samrpat/light-alarm-clock/README.md

# light-alarm-clock
A custom alarm clock to replace current one and add more features.

Sunrise light, sleep sounds and a gesture-driven round touchscreen, built on an ESP32-S3.
Start with [docs/README.md](docs/README.md).
