samrpat/light-alarm-clock/docs/POWER.md

# Power design

Phase 1 · 2026-11-12 · Decisions: [D-012](DECISIONS.md), [D-013](DECISIONS.md), [D-014](DECISIONS.md)

**All currents below are estimates from datasheet-typical figures. None has been measured yet.**
Section 9 lists the bench measurements that replace them.

## 1. Architecture in one picture

```mermaid
flowchart LR
  PSU[USB-C adapter<br/>5 V, 3 A] --> USBC[Board USB-C]
  USBC --> VBUS((VBUS))
  VBUS --> AXP[AXP2101<br/>input limit 1.0 A]
  AXP --> R33[3.3 V rails:<br/>ESP32, display, codec]
  AXP <--> BAT[Li-ion 2000 mAh<br/>backup, MX1.25]
  AXP --> RTC[PCF85063 RTC]
  VBUS -- header pin 1 --> PTC[PTC fuse 1.1 A] --> CAP[1000 µF] --> RING[RGBW ring<br/>firmware cap 0.9 A]
  VBUS --> LS[74AHCT125]
  GPIO17 --> LS -- 470 Ω --> RING
```

- **USB-C is the main supply.** The ring takes 5 V directly from the header's VBUS pin.
- **The battery is a backup.** It carries the clock, the RTC and the alarm sound through an unplug or a power cut. The ring is off on battery.
- **No boost converter** in the baseline. Section 8 describes it as an optional upgrade.

## 2. LED ring load (24 × RGBW)

| Case | Channels on | Ring current at 5 V |
|---|---|---|
| Powered but dark (driver quiescent, ~1 mA each) | none | ~25 mA |
| Night light, red at 3 % | R | ~40 mA |
| Reading light, white at 60 % | W | ~285 mA |
| White LED at 100 % | W | ~455 mA |
| Sunrise peak (white 100 % + warm tint) | W + R + part G | ~0.85 A |
| Everything at 100 % (never allowed) | R+G+B+W | ~1.75 A |

Per-channel figure used: 18 mA (Adafruit's stated constant current).

**Firmware current cap (R14):** before every frame, `light_fx` adds up
`I = 25 mA + Σ(r+g+b+w) × 18 mA / 255` over all 24 pixels.
If `I > 900 mA`, every channel is scaled down by `900 / I`. No mode can bypass this.

**Hardware backstop:** a 1.1 A-hold resettable fuse (Bourns MF-R110) in the ring's 5 V line. If firmware ever fails with all channels on, the fuse trips instead of the adapter or the board trace.

**Weak-charger guard:** `power_mon` reads VBUS voltage from the AXP2101 once a second while the ring is lit. Below 4.6 V the cap drops in 20 % steps until VBUS recovers.

**The dawn (LIGHT.md §3) peaks at about 0.6 A:** 24 LEDs with white at full and a little red, green and blue, about 25 mA of idle current, well under the 0.9 A cap. The night face and the ring-off rule mean the ring draws almost nothing overnight.

## 3. Level shifting and protection parts

| Part | Value | Why |
|---|---|-----|
| 74AHCT125 (one gate, VCC = VBUS) | — | The ring needs a data high of at least 0.7 × 5 V = 3.5 V. The ESP32 gives 3.3 V. AHCT reads 3.3 V as high and outputs 5 V. |
| Series resistor at ring DIN | 470 Ω | Damps ringing on the data wire and limits current into the first pixel. |
| Pull-down on gate input (GPIO17) | 10 kΩ | Holds data low while the ESP32 boots, so the ring doesn't flash random colours. |
| Bulk capacitor across ring 5 V/GND | 1000 µF, 10 V | Absorbs the current step when the ring changes brightness. If an adapter hiccups at plug-in from the inrush, drop to 470 µF. |
| Decoupling at the 74AHCT125 | 100 nF | Standard. |
| Unused gates (3) | inputs to GND, /OE to VCC | Stops them floating. |

AHCT inputs accept a signal while their own supply is off, so GPIO17 cannot back-feed VBUS when USB is unplugged. Firmware also parks GPIO17 low when VBUS is absent.

## 4. Power budget

Converted to current at the 5 V USB input (3.3 V loads ÷ 0.88 regulator efficiency).

| State | Board | Ring | Total at 5 V |
|---|---|---|---|
| A. Night clock, dim | 45 mA | 25 mA | **~70 mA** |
| B. White noise playing | 75 mA | 25 mA | **~100 mA** |
| C. Night light | 45 mA | 40 mA | **~85 mA** |
| D. Reading light 60 % | 50 mA | 285 mA | **~335 mA** |
| E. Sunrise at peak | 75 mA | 900 mA (cap) | **~1.0 A** |
| F. Alarm, full volume, sunrise full | 410 mA | 900 mA | **~1.3 A** |
| G. F + battery charging | 1000 mA (PMIC limit) | 900 mA | **1.9 A max** |

Board-side detail used above (at 3.3 V): ESP32-S3 ~40 mA average with radios idle, up to 340 mA in Wi-Fi bursts · AMOLED ~10 mA dim, ~100 mA full white · codec ~15 mA · sensors and PMIC ~5 mA · amplifier ~25 mA for white noise, ~1.2 W at full alarm volume.

**Adapter:** 5 V, **3 A**, USB-C (for example the Raspberry Pi 15 W supply, 5.1 V / 3 A). A phone charger of 2 A or more works; the weak-charger guard dims the ring if it sags. A laptop port (0.5–0.9 A) will run the clock but not the full sunrise.

## 5. PMIC (AXP2101) settings, applied at every boot

| Setting | Value | Reason |
|---|---|---|
| VBUS input current limit | 1000 mA | Leaves the rest of the adapter for the ring. |
| Battery charge current | 400 mA (0.2 C for 2000 mAh) | Gentle on the cell, low heat in a closed case. |
| Charge target voltage | **4.1 V** (owner choice) | The clock lives on USB, and 4.1 V gives much longer cell life. Costs about 10 % of capacity; the runtime table below already has that margin. |
| PWR-key long-press power-off | Disabled (or 10 s if it can't be disabled) | R27: no accidental power-off. |
| IRQs enabled | VBUS insert/remove, battery low, charge done, PWR key | Read through TCA9554 P5; also polled every 1 s. |
| Fuel gauge | Enabled | Battery % for R24/R25. |

Register names and library calls are confirmed in Phase 3 against the AXP2101 datasheet.

## 6. Battery (backup) and runtime

**Recommendation (D-035):** a 3.7 V Li-polymer **503450 cell (5 × 34 × 50 mm), about 1000 mAh**, with a built-in protection board and a **1.25 mm 2-pin plug** (Molex PicoBlade type). Order by specification and follow the checklist in HARDWARE.md §1. It is thin so the case can stay thin, and it is a consumable you replace every 3–5 years.

> **Check polarity before plugging in.** Hobby cells often have red and black swapped relative to a given board, and Waveshare's documents do not state the polarity. Reversed polarity can destroy the PMIC.

Usable energy: 1000 mAh × 3.7 V = 3.7 Wh, × 0.8 (ageing, cut-off) = **about 3.0 Wh**. Everything below is calculated, not measured.

| On battery | Power | Runtime |
|---|---|---|
| Clock only, dim | 0.20 W | about 15 h |
| White noise continuously | 0.35 W | about 8.5 h |
| Alarm at full volume, screen white | 2.0 W | 0.33 Wh per 10 min |
| **A typical unplugged night: 90 min of white noise, 6.5 h clock only, 10 min alarm** | — | **2.2 Wh, about 73 % of usable** |
| A full 8 h of white noise plus the alarm | — | 3.1 Wh, **105 %: not covered** |

So the thin cell covers a normal night and any power cut, but not eight hours of noise on battery. A thicker 1500–2000 mAh cell would (and costs 3–5 mm of case thickness).

Without any battery: the clock works on USB, but an unplug or power cut stops it and the RTC loses the time. On power return it shows "Set time" and the alarm waits until you set it (LONGEVITY.md §2). Any alarm in that gap is missed.

## 7. Behaviour on power events

| Event | What the clock does |
|---|---|
| USB unplugged | Ring goes dark at once (it has no supply). Sound and screen continue on battery with no reset. Screen shows a small "on battery" mark. |
| USB unplugged during sunrise or alarm | Alarm continues with sound. The screen ramps to full white in place of the ring. |
| USB plugged back | Ring resumes whatever it should be showing. Charging restarts. |
| Bedtime on battery (unplugged after 20:00, or white noise started on battery) | Works out energy needed until the next alarm plus a 0.4 Wh alarm reserve. If the battery has less than 1.25 × that, shows "Plug me in" and chimes (R24). |
| Battery < 25 % | White noise fades out. Wi-Fi and Bluetooth off. Screen at minimum (R25). |
| Battery < 10 % | Screen off unless touched. Only the alarm path runs. |
| Battery < 4 % or < 3.3 V | Saves state, then powers down cleanly (R31). |
| Power returns after shutdown | Boots, restores time from the RTC, fires any alarm missed in the last 60 min (R20). |
| Brownout (3.3 V rail dips) | ESP32 brownout detector resets the chip. Boot logic resumes the alarm stage from the clock time (R21). |

## 8. Optional upgrade: sunrise light on battery

Not built in the baseline. Add it only if you want the full sunrise when unplugged.

- Splice a tap into the battery leads (the header has no battery pin).
- Adafruit PowerBoost 1000 Basic (#2030): battery in, 5 V / 1 A out, with an enable pin driven from GPIO18.
- Two Schottky diodes (1N5822) to combine VBUS and boost output into the ring's supply.
- Battery of at least 3000 mAh. A 30 min sunrise costs about 1.2 Wh extra.

## 9. Bench measurements to replace the estimates

| # | Measure | Expect | Feeds |
|---|---|---|---|
| M1 | USB current in states A–F (inline USB meter) | within ±30 % of §4 | R29, T-29 |
| M2 | VBUS at the ring with the ring at the 0.9 A cap | ≥ 4.6 V | R32, T-32 |
| M3 | Ring current at white 100 % and at the cap | ~0.46 A, ≤ 0.9 A | R14, T-14 |
| M4 | Battery runtime with white noise | ≥ 12 h | R30, T-30 |
| M5 | Which rail feeds the NS4150B amplifier | sets real max speaker power | HARDWARE §4 |
| M6 | Temperature of ring and PTC after 30 min at the cap | < 60 °C | Phase 4 enclosure |

## 10. Planned for PCB v2: USB-C power input on the PCB (D-021)

Not built yet. The breadboard build and sections 1–7 above still describe the first run.

```mermaid
flowchart LR
  PSU[USB-C adapter 5 V 3 A] --> J[USB-C socket on the PCB<br/>rear of the case]
  J --> SW[Ring power switch<br/>2 A limit, on/off, fault flag]
  SW --> CAP[1000 µF] --> RING[RGBW ring]
  J --> D[Ideal diode] -- header VBUS pin --> BOARD[Waveshare board<br/>PMIC limit 1.0 A]
  J -. CC voltage .-> ADC[GPIO16: how much the adapter offers]
  GPIO18 --> SW
  GPIO17 --> LS[Level shifter] --> RING
  BOARD <--> BAT[Backup battery]
```

| Block | Part (candidate) | Job |
|---|---|-----|
| USB-C socket, power only | GCT USB4125-GF-A (6-pin) with 5.1 kΩ on CC1 and CC2 | Cable leaves from the back of the case. The resistors make a USB-C supply turn on 5 V. |
| Ring power switch | TI TPS25200 (adjustable limit, set to 2.0 A) | Turns the ring fully off when dark, limits current in hardware, reports faults. Replaces the PTC fuse. |
| Board feed | Ideal diode, e.g. TI LM66100, into header VBUS | Powers the Waveshare board from the PCB. Blocks back-feed if a computer is also plugged into the board's own port for flashing. |
| Adapter sensing | CC1/CC2 → resistor network → GPIO16 (ADC) | Reads what the adapter advertises: 3 A, 1.5 A or basic USB. |
| Level shifter | 74AHCT1G125 (single gate, SOT-23-5) | Same job as today, smaller. |

**What it changes**
- The ring no longer draws through the Waveshare board, so the 0.9 A cap (set because the board's VBUS pin and trace are unknown) goes away.
- New budget with a 3 A adapter: board ≤ 1.0 A + ring up to 1.75 A (all four colours at 100 %) = 2.75 A.
- Firmware still sets a ceiling, chosen from what the adapter advertises: 3 A adapter → full ring; 1.5 A → about 0.4 A; basic USB → night light only, with a "use a 3 A charger" message. The VBUS sag guard stays as a second check.

**Limits that remain**
- Heat. A ring at 1.75 A is about 9 W inside a small printed case. The real ceiling is set by temperature test M6 in Phase 4, not by the electronics.
- The useful sunrise colours (white plus warm tint) need about 1.0 A. Full 1.75 A adds red, green and blue on top, which is brighter but cooler in colour.
- On battery the ring is still dark.
- Flashing over USB still uses the Waveshare board's own port, so the case needs a small access hole for it, or updates go over Wi-Fi (Phase 7).

**Check needed first (V10):** feed 5 V into the header VBUS pin with nothing in the board's USB port, and confirm the board runs and charges the battery. Waveshare's note on that pin says to "observe power-sharing and backfeed requirements" without giving details.
