samrpat/light-alarm-clock/firmware/bringup/main/main.c

/*
 * Hardware bring-up test for the sunrise alarm clock.
 * NOT the product firmware (that starts in Phase 3). It only proves the parts work:
 *   screen + touch, the RGBW ring on GPIO17, the speaker, and the chips on the I2C bus.
 *
 * Tap the screen to step through the tests:
 *   Idle -> Dawn (54 s loop of the 40-minute plan) -> Evening light -> Night light -> White noise -> Tone -> Idle
 *
 * Safety: the ring is held to RING_CAP_MA (300 mA) because this test rig has no fuse.
 */
#include <math.h>
#include <stdio.h>
#include <string.h>
#include "freertos/FreeRTOS.h"
#include "freertos/task.h"
#include "esp_log.h"
#include "esp_random.h"
#include "esp_timer.h"
#include "driver/i2c_master.h"
#include "bsp/esp-bsp.h"
#include "bsp/display.h"
#include "esp_codec_dev.h"
#include "led_strip.h"
#include "lvgl.h"

static const char *TAG = "bringup";

#define RING_GPIO     17      /* header pin 6, see docs/HARDWARE.md */
#define RING_LEDS     24
#define RING_CAP_MA   300     /* firmware current cap for this un-fused test */
#define MA_PER_CH     18      /* Adafruit: ~18 mA per colour channel at full */
#define RING_IDLE_MA  25
#define SAMPLE_RATE   22050

enum { MODE_IDLE, MODE_SUNRISE, MODE_READING, MODE_NIGHT, MODE_NOISE, MODE_TONE, MODE_COUNT };
static const char *MODE_NAME[MODE_COUNT] = {"Idle", "Dawn", "Evening light", "Night light", "White noise", "Tone 440 Hz"};
static volatile int s_dawn_min;                           /* minutes from the alarm time, for the screen */
static volatile int s_mode = MODE_IDLE;
static volatile int64_t s_mode_t0;

static led_strip_handle_t s_ring;
static esp_codec_dev_handle_t s_spk;
static lv_obj_t *s_time_lbl, *s_mode_lbl, *s_info_lbl;
static volatile int s_ring_ma;

/* ---------- ring ---------- */
typedef struct { float r, g, b, w; } rgbw_t;   /* each channel 0.0 .. 255.0, fractions allowed */

/*
 * Fill the ring with one colour, smoothly.
 * An LED only accepts whole steps 0..255, and at low brightness one step is a visible jump.
 * So the fractional part is spread out two ways:
 *   - across the ring: each LED rounds up at a different point, giving 24 in-between levels;
 *   - across time: the rounding point shifts every frame (4-frame cycle at 250 Hz), giving 4 more.
 * Together that is about 96 finer levels between any two whole steps.
 * The colour is also scaled down if it would exceed the current cap.
 */
static void ring_fill(rgbw_t c)
{
    static uint32_t frame;
    if (!s_ring) return;
    float ma = RING_IDLE_MA + (c.r + c.g + c.b + c.w) * RING_LEDS * MA_PER_CH / 255.0f;
    if (ma > RING_CAP_MA) {
        float k = (RING_CAP_MA - RING_IDLE_MA) / (ma - RING_IDLE_MA);
        c.r *= k; c.g *= k; c.b *= k; c.w *= k;
        ma = RING_CAP_MA;
    }
    s_ring_ma = (int)ma;
    float ch[4] = { c.r, c.g, c.b, c.w };
    uint8_t out[4];
    float tphase = (frame++ & 3) * 0.25f / RING_LEDS;        /* time shift, finer than one LED slot */
    for (int i = 0; i < RING_LEDS; i++) {
        /* golden-ratio order so neighbouring LEDs do not step together */
        float thr = fmodf(i * 0.6180340f, 1.0f) + tphase;
        if (thr >= 1.0f) thr -= 1.0f;
        for (int k = 0; k < 4; k++) {
            /* a different offset per colour so the four LEDs in a pixel do not step together */
            float t = thr + k * 0.25f; if (t >= 1.0f) t -= 1.0f;
            float v = ch[k] + t;
            out[k] = v >= 255.0f ? 255 : (uint8_t)v;
        }
        led_strip_set_pixel_rgbw(s_ring, i, out[0], out[1], out[2], out[3]);
    }
    led_strip_refresh(s_ring);
}

/*
 * The dawn plan from docs/LIGHT.md section 3. t is minutes from the alarm time, -30 to +10.
 *   output fraction F: exponential, 0.2 % at T-30 rising to 100 % at T, then held
 *   T-30..T-15  deep red only (passes closed eyelids, little effect on the body clock)
 *   T-15..T-5   red, with green and a little white added (amber)
 *   T-5..T      the white LED takes over (warm white), red and green fade to a tint
 *   T..T+10     white stays full, red goes, a little blue is added (brighter, cooler, you are awake)
 */
static rgbw_t dawn_colour(float t)
{
    float x = (t + 30.0f) / 30.0f;
    if (x < 0) x = 0;
    if (x > 1) x = 1;
    float F = powf(0.002f, 1.0f - x);
    float R, G, W, B = 0;
    if (t < -15.0f)      { R = 1;  G = 0;  W = 0; }
    else if (t < -5.0f)  { float k = (t + 15.0f) / 10.0f; R = 1; G = 0.40f * k; W = 0.15f * k; }
    else if (t < 0.0f)   { float k = (t + 5.0f) / 5.0f; R = 1 - 0.70f * k; G = 0.40f - 0.25f * k; W = 0.15f + 0.85f * k; }
    else                 { float k = t / 10.0f; if (k > 1) k = 1; R = 0.30f * (1 - k); G = 0.15f - 0.05f * k; W = 1; B = 0.25f * k; }
    rgbw_t c = { .r = 255.0f * F * R, .g = 255.0f * F * G, .b = 255.0f * F * B, .w = 255.0f * F * W };
    return c;
}

static void ring_task(void *arg)
{
    while (1) {
        float t = (esp_timer_get_time() - s_mode_t0) / 1e6f;
        switch (s_mode) {
        case MODE_SUNRISE: {                             /* 40 virtual minutes in 48 s (1.2 s each), hold 6 s, repeat */
            float u = fmodf(t, 54.0f);
            float m = -30.0f + (u < 48.0f ? u : 48.0f) / 1.2f;
            s_dawn_min = (int)floorf(m);
            ring_fill(dawn_colour(m));
            break;
        }
        case MODE_READING: {                             /* evening light: warm, capped at 20 % (LIGHT.md section 4) */
            rgbw_t c = { .r = 255.0f * 0.2f * 0.35f, .g = 255.0f * 0.2f * 0.25f, .b = 0, .w = 255.0f * 0.2f * 0.40f };
            ring_fill(c);
            break;
        }
        case MODE_NIGHT: {                               /* night light: red only, about 3 % */
            rgbw_t c = { .r = 255.0f * 0.03f, .g = 0, .b = 0, .w = 0 };
            ring_fill(c);
            break;
        }
        default:           ring_fill((rgbw_t){0, 0, 0, 0}); break;
        }
        vTaskDelay(pdMS_TO_TICKS(4));                    /* 250 frames a second */
    }
}

static void ring_init(void)
{
    led_strip_config_t cfg = {
        .strip_gpio_num = RING_GPIO,
        .max_leds = RING_LEDS,
        .led_model = LED_MODEL_SK6812,
        .color_component_format = LED_STRIP_COLOR_COMPONENT_FMT_GRBW,
    };
    led_strip_rmt_config_t rmt = { .clk_src = RMT_CLK_SRC_DEFAULT, .resolution_hz = 10 * 1000 * 1000 };
    esp_err_t err = led_strip_new_rmt_device(&cfg, &rmt, &s_ring);
    ESP_LOGI(TAG, "ring on GPIO%d: %s", RING_GPIO, esp_err_to_name(err));
    if (err == ESP_OK) led_strip_clear(s_ring);
}

/* ---------- audio ---------- */
static void audio_task(void *arg)
{
    static int16_t buf[512];
    float phase = 0;
    while (1) {
        int mode = s_mode;
        for (int i = 0; i < 512; i++) {
            if (mode == MODE_NOISE) buf[i] = (int16_t)((int32_t)(esp_random() & 0xFFFF) - 32768) / 8;
            else if (mode == MODE_TONE) { buf[i] = (int16_t)(sinf(phase) * 6000); phase += 2 * M_PI * 440 / SAMPLE_RATE; if (phase > 2 * M_PI) phase -= 2 * M_PI; }
            else buf[i] = 0;
        }
        if (s_spk) esp_codec_dev_write(s_spk, buf, sizeof(buf));
        else vTaskDelay(pdMS_TO_TICKS(20));
    }
}

static void audio_init(void)
{
    s_spk = bsp_audio_codec_speaker_init();
    if (!s_spk) { ESP_LOGE(TAG, "speaker init failed"); return; }
    esp_codec_dev_sample_info_t fs = { .sample_rate = SAMPLE_RATE, .channel = 1, .bits_per_sample = 16 };
    esp_err_t err = esp_codec_dev_open(s_spk, &fs);
    esp_codec_dev_set_out_vol(s_spk, 60);
    ESP_LOGI(TAG, "speaker: %s", err == ESP_OK ? "ok" : "open failed");
}

/* ---------- I2C scan + power chip ---------- */
static i2c_master_dev_handle_t s_axp;

static int axp_read16(uint8_t reg)
{
    uint8_t d[2];
    if (!s_axp || i2c_master_transmit_receive(s_axp, &reg, 1, d, 2, 100) != ESP_OK) return -1;
    return ((d[0] & 0x3F) << 8) | d[1];         /* 14-bit result, 1 mV per step */
}

static void i2c_report(void)
{
    static const struct { uint8_t addr; const char *name; } dev[] = {
        {0x18, "ES8311 codec"}, {0x20, "TCA9554 expander"}, {0x34, "AXP2101 power"}, {0x40, "ES7210 mic ADC"},
        {0x51, "PCF85063 RTC"}, {0x5A, "CST9217 touch"}, {0x6B, "QMI8658 IMU"},
    };
    i2c_master_bus_handle_t bus = bsp_i2c_get_handle();
    for (int i = 0; i < 7; i++)
        ESP_LOGI(TAG, "I2C 0x%02X %-17s %s", dev[i].addr, dev[i].name,
                 i2c_master_probe(bus, dev[i].addr, 100) == ESP_OK ? "found" : "MISSING");
    i2c_device_config_t c = { .dev_addr_length = I2C_ADDR_BIT_LEN_7, .device_address = 0x34, .scl_speed_hz = 100000 };
    if (i2c_master_bus_add_device(bus, &c, &s_axp) == ESP_OK) {
        uint8_t en[2] = {0x30, 0xFF};            /* switch on the chip's voltage measurements (unverified register) */
        i2c_master_transmit(s_axp, en, 2, 100);
    }
#ifdef BSP_I2S_MCLK
    ESP_LOGI(TAG, "BSP pins: I2S MCLK=%d BCLK=%d LRCK=%d DOUT=%d, amp enable=%d",
             BSP_I2S_MCLK, BSP_I2S_SCLK, BSP_I2S_LCLK, BSP_I2S_DOUT, BSP_POWER_AMP_IO);
#endif
}

/* ---------- screen ---------- */
static void on_tap(lv_event_t *e)
{
    s_mode = (s_mode + 1) % MODE_COUNT;
    s_mode_t0 = esp_timer_get_time();
    ESP_LOGI(TAG, "mode -> %s", MODE_NAME[s_mode]);
}

static void ui_tick(lv_timer_t *t)
{
    int s = esp_timer_get_time() / 1000000;
    lv_label_set_text_fmt(s_time_lbl, "%02d:%02d", s / 60 % 60, s % 60);
    if (s_mode == MODE_SUNRISE) lv_label_set_text_fmt(s_mode_lbl, "Dawn T%+d min", s_dawn_min);
    else lv_label_set_text(s_mode_lbl, MODE_NAME[s_mode]);
    lv_label_set_text_fmt(s_info_lbl, "ring %d mA  USB %d mV\ntap to change", s_ring_ma, axp_read16(0x38));
}

static void ui_init(void)
{
    lv_obj_t *scr = lv_screen_active();
    lv_obj_set_style_bg_color(scr, lv_color_black(), 0);
    lv_obj_add_flag(scr, LV_OBJ_FLAG_CLICKABLE);
    lv_obj_add_event_cb(scr, on_tap, LV_EVENT_CLICKED, NULL);

    s_time_lbl = lv_label_create(scr);
    lv_obj_set_style_text_font(s_time_lbl, &lv_font_montserrat_48, 0);
    lv_obj_set_style_text_color(s_time_lbl, lv_color_hex(0xFFB869), 0);
    lv_obj_align(s_time_lbl, LV_ALIGN_CENTER, 0, -40);

    s_mode_lbl = lv_label_create(scr);
    lv_obj_set_style_text_font(s_mode_lbl, &lv_font_montserrat_20, 0);
    lv_obj_set_style_text_color(s_mode_lbl, lv_color_hex(0xFFB869), 0);
    lv_obj_align(s_mode_lbl, LV_ALIGN_CENTER, 0, 20);

    s_info_lbl = lv_label_create(scr);
    lv_obj_set_style_text_color(s_info_lbl, lv_color_hex(0xB27C4A), 0);
    lv_obj_set_style_text_align(s_info_lbl, LV_TEXT_ALIGN_CENTER, 0);
    lv_obj_align(s_info_lbl, LV_ALIGN_CENTER, 0, 80);

    lv_timer_create(ui_tick, 250, NULL);
}

void app_main(void)
{
    ESP_LOGI(TAG, "bring-up test starting");
    bsp_display_start();
    bsp_display_brightness_set(60);
    i2c_report();
    ring_init();
    audio_init();

    bsp_display_lock(-1);
    ui_init();
    bsp_display_unlock();

    s_mode_t0 = esp_timer_get_time();
    xTaskCreatePinnedToCore(ring_task, "ring", 4096, NULL, 6, NULL, 1);
    xTaskCreatePinnedToCore(audio_task, "audio", 4096, NULL, 7, NULL, 1);
}
