samrpat/light-alarm-clock/(commit log)

2026-11-13 Phase 0 and 1: requirements, architecture, power and wiring design
    Adds the project docs (requirements, decisions, firmware architecture,
    power budget, BOM, pin table, wiring) and the interactive UX concept.
2026-11-13 Add halo driver PCB v1 and record owner answers
    44 x 28 mm through-hole board for the NeoPixel level shifter, fuse and
    bulk capacitor, generated and checked by pcb/halo-driver/gen_pcb.py.
    [halo-driver-NPTH.DRL, halo-driver-PTH.DRL, halo-driver.GBL, halo-driver.GBO, halo-driver.GBS, halo-driver.GKO, halo-driver.GTL, halo-driver.GTO]
2026-11-13 Plan first build on breadboard; defer PCB until case design
2026-11-13 Plan PCB v2 with rear USB-C power input and ring power switch
2026-11-13 Add hardware bring-up test firmware
    Screen, touch, RGBW ring sunrise on GPIO17 and speaker test using the
    Waveshare board package on ESP-IDF v5.5.6. Compiles; not yet run on hardware.
2026-11-13 Phase 2: UX and gesture design; fewest-parts rule
    UX.md with gesture vocabulary, screen map, wireframes, night theme and
    acceptance checks. Decisions D-023 and D-024. Concept page updated for the
    hold-to-turn-off rule.
2026-11-13 Phase 2 revision: dynamic face, short settings, touch dial, light plan, 30-year offline plan
    Adds LIGHT.md and LONGEVITY.md, decisions D-030 to D-035, a rebuilt concept
    page (257 states, 0 layout issues), the new dawn sequence in the bring-up
    firmware (compiles, not yet flashed), and a thin battery specification.
    Includes the in-progress enclosure draft from a parallel session.
    [main.c]
2026-11-13 Phase 2 revision: one way to edit (dots), settings as pictures, softer 30-year wording
    Measured a rim-band dial hijacking 60% of sideways swipes and replaced it with
    grab-a-dot dials like clock hands (0 of 1,249 random swipes mistaken). Removed
    buttons. Eight settings pages designed as pictures of what they set. Added
    firmware/dialtest for the real touch screen. Owner answers recorded.
    [main.c]
2026-11-14 Round 10: pre-dawn sleep sound, living sky, Apple-style type, Focus timer
2026-11-14 Focus timer: pill buttons and settings menu
